LaskaKit/ESP32-S3-DEVKit/Version.md

### Version 1.3
- New power part, layout optimization | 
- Jumpers added to USB-HOST power
- New user button on pin io40
#### Version 1.2
- Adjustment of the IC1 switching | Upravá spinání IC1
#### Version 1.1
- D4 deleted | odstraněná dioda D4
#### Version 1.0
- Initial | Počáteční
