LaskaKit/ESP32-S3-DEVKit/img/ESP32-S3-DEVKit_back.png

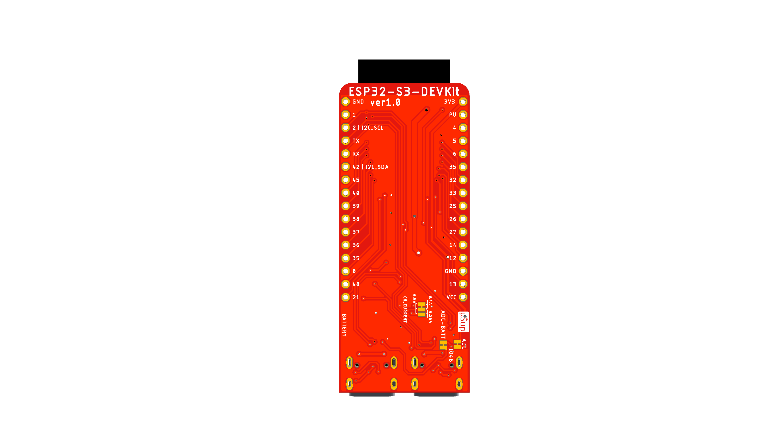
img/ESP32-S3-DEVKit_back.png
