LaskaKit/ESP32-S3-DEVKit/img/ESP32-S3-Devkit_pinout.JPG

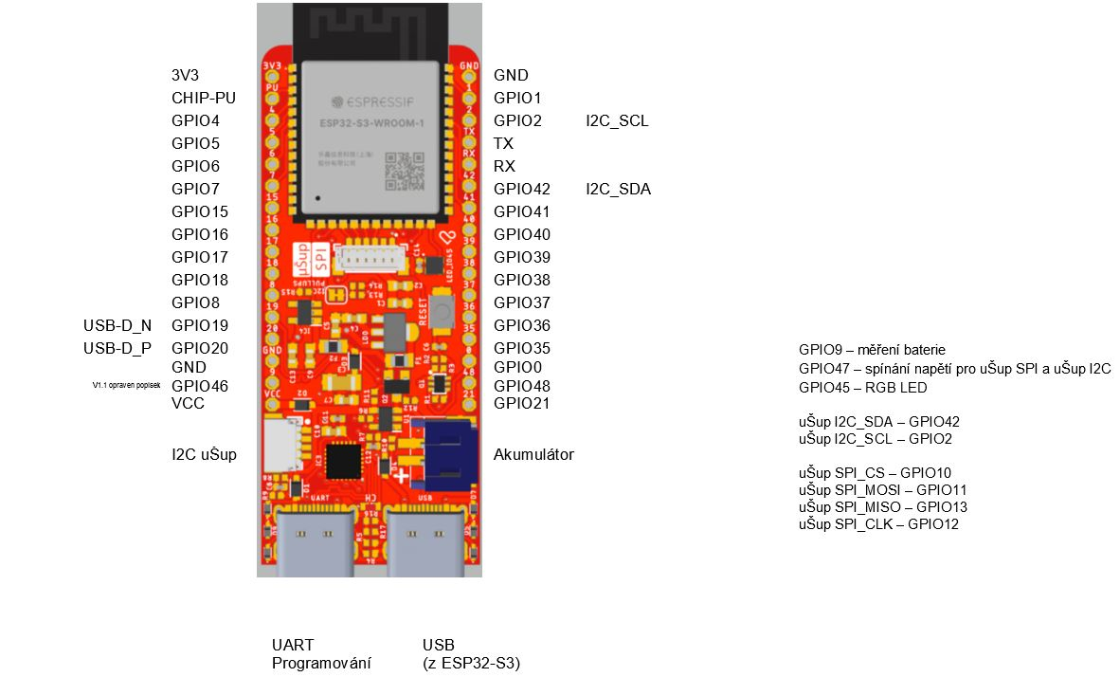
img/ESP32-S3-Devkit_pinout.JPG
