LaskaKit/ESP32-S3-DEVKit/img/LaskaKit-esp32-s3-devkit-1.jpg

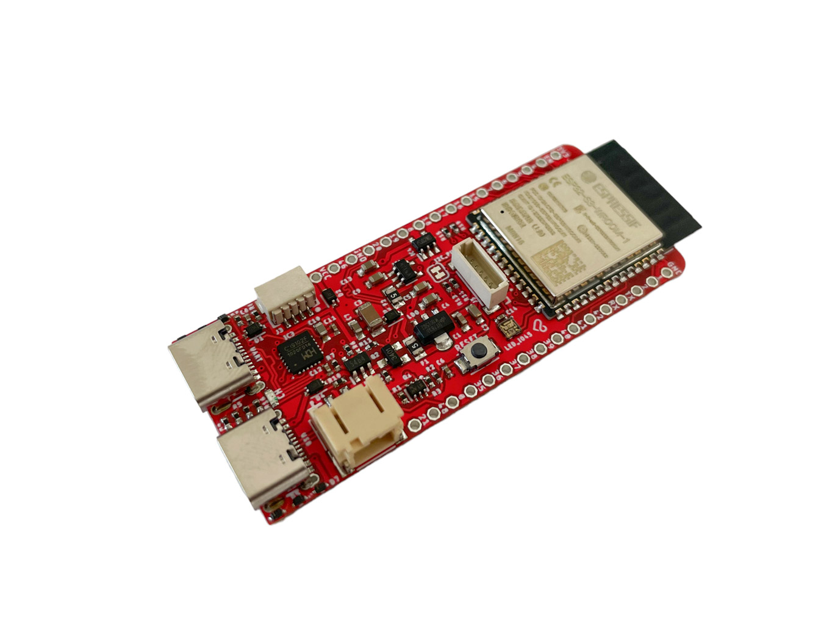
img/LaskaKit-esp32-s3-devkit-1.jpg
