LaskaKit/ESP32-S3-DEVKit/HW/ESP32-S3-DEVKit_v1_3.pdf

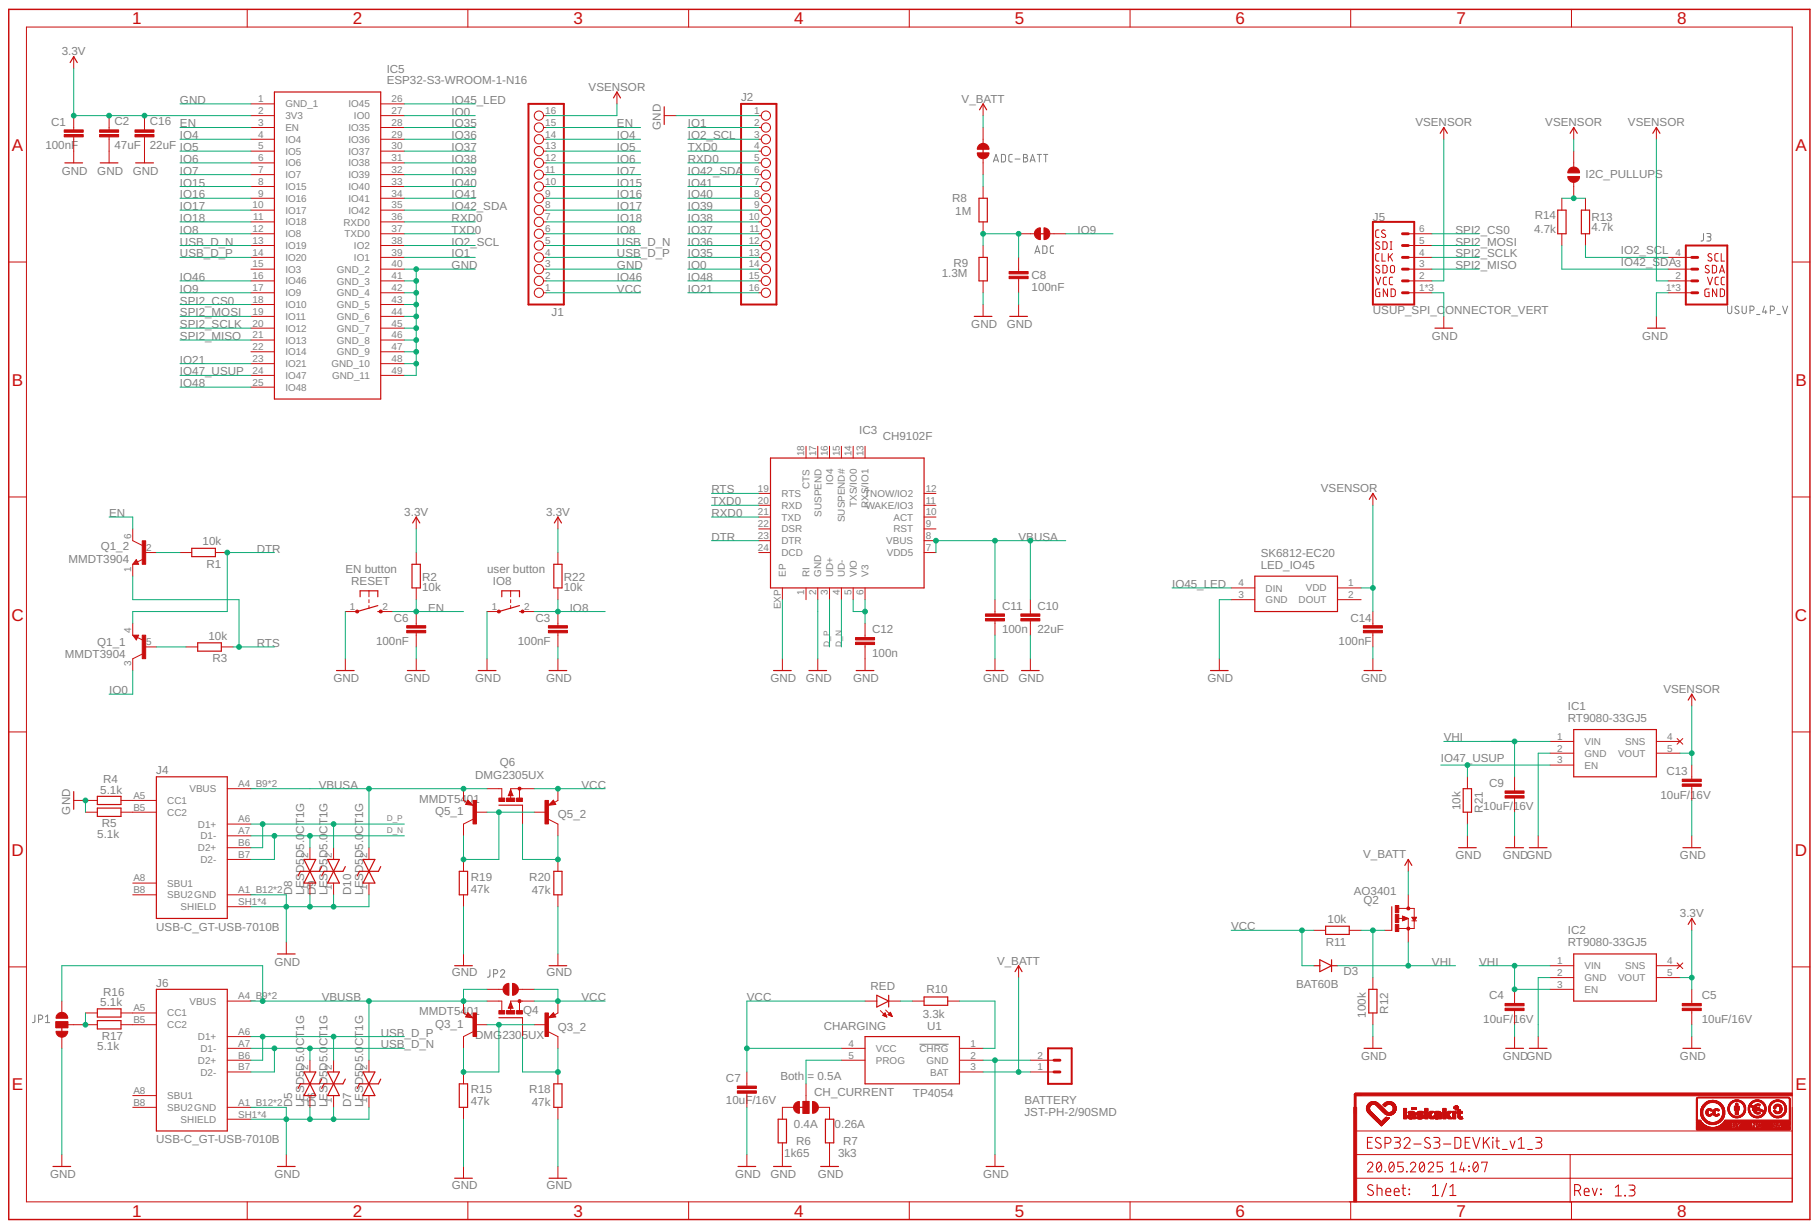
[picture p7: page 1]
