LaskaKit/ESP32-S3-DEVKit/HW/old/ESP32-S3-DEVKit_v1_1.pdf

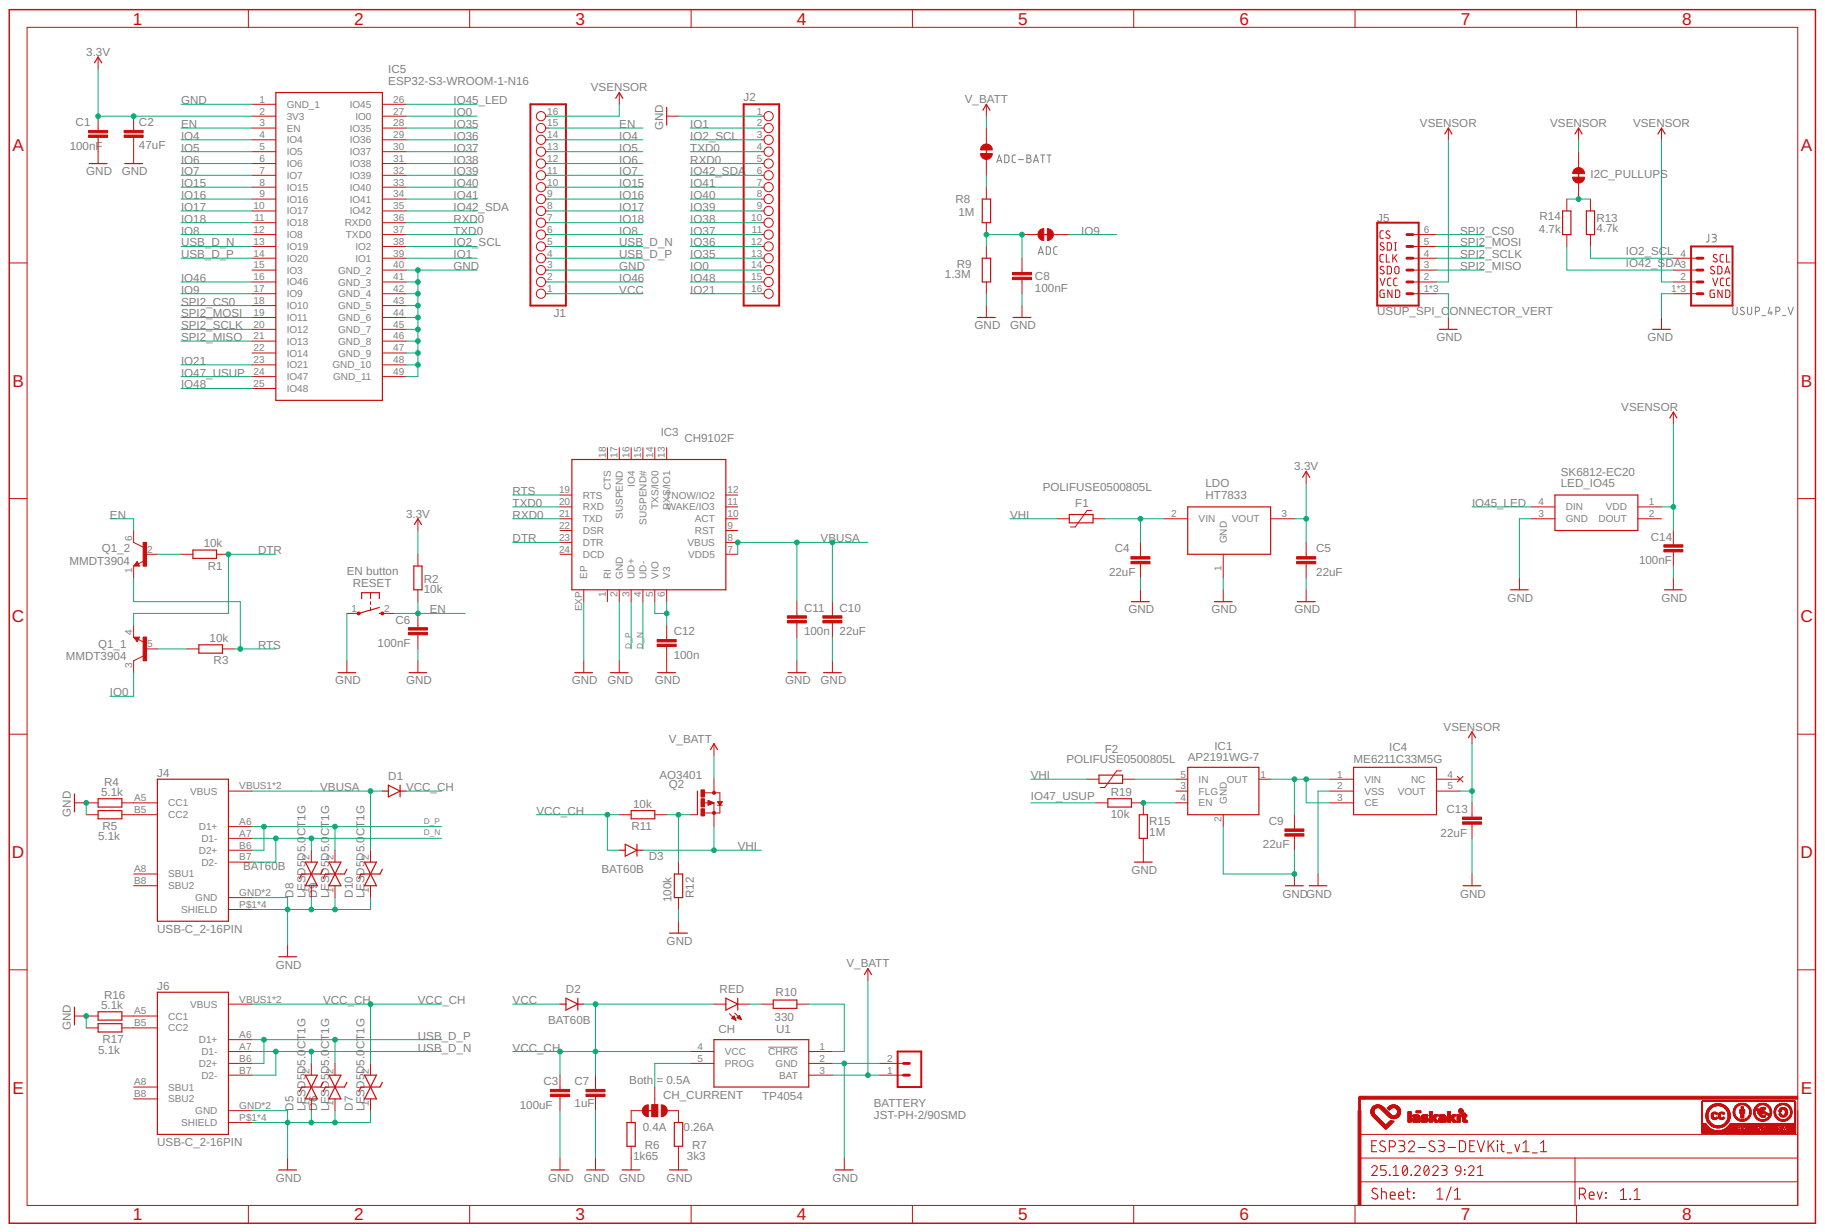
[picture p8: page 1]
