LaskaKit/ESP32-S3-DEVKit/HW/old/ESP32-S3-DEVKit_V1_0.pdf

A

1 | 2 | 3 | 4 | 5 | 6 | 7 | 8

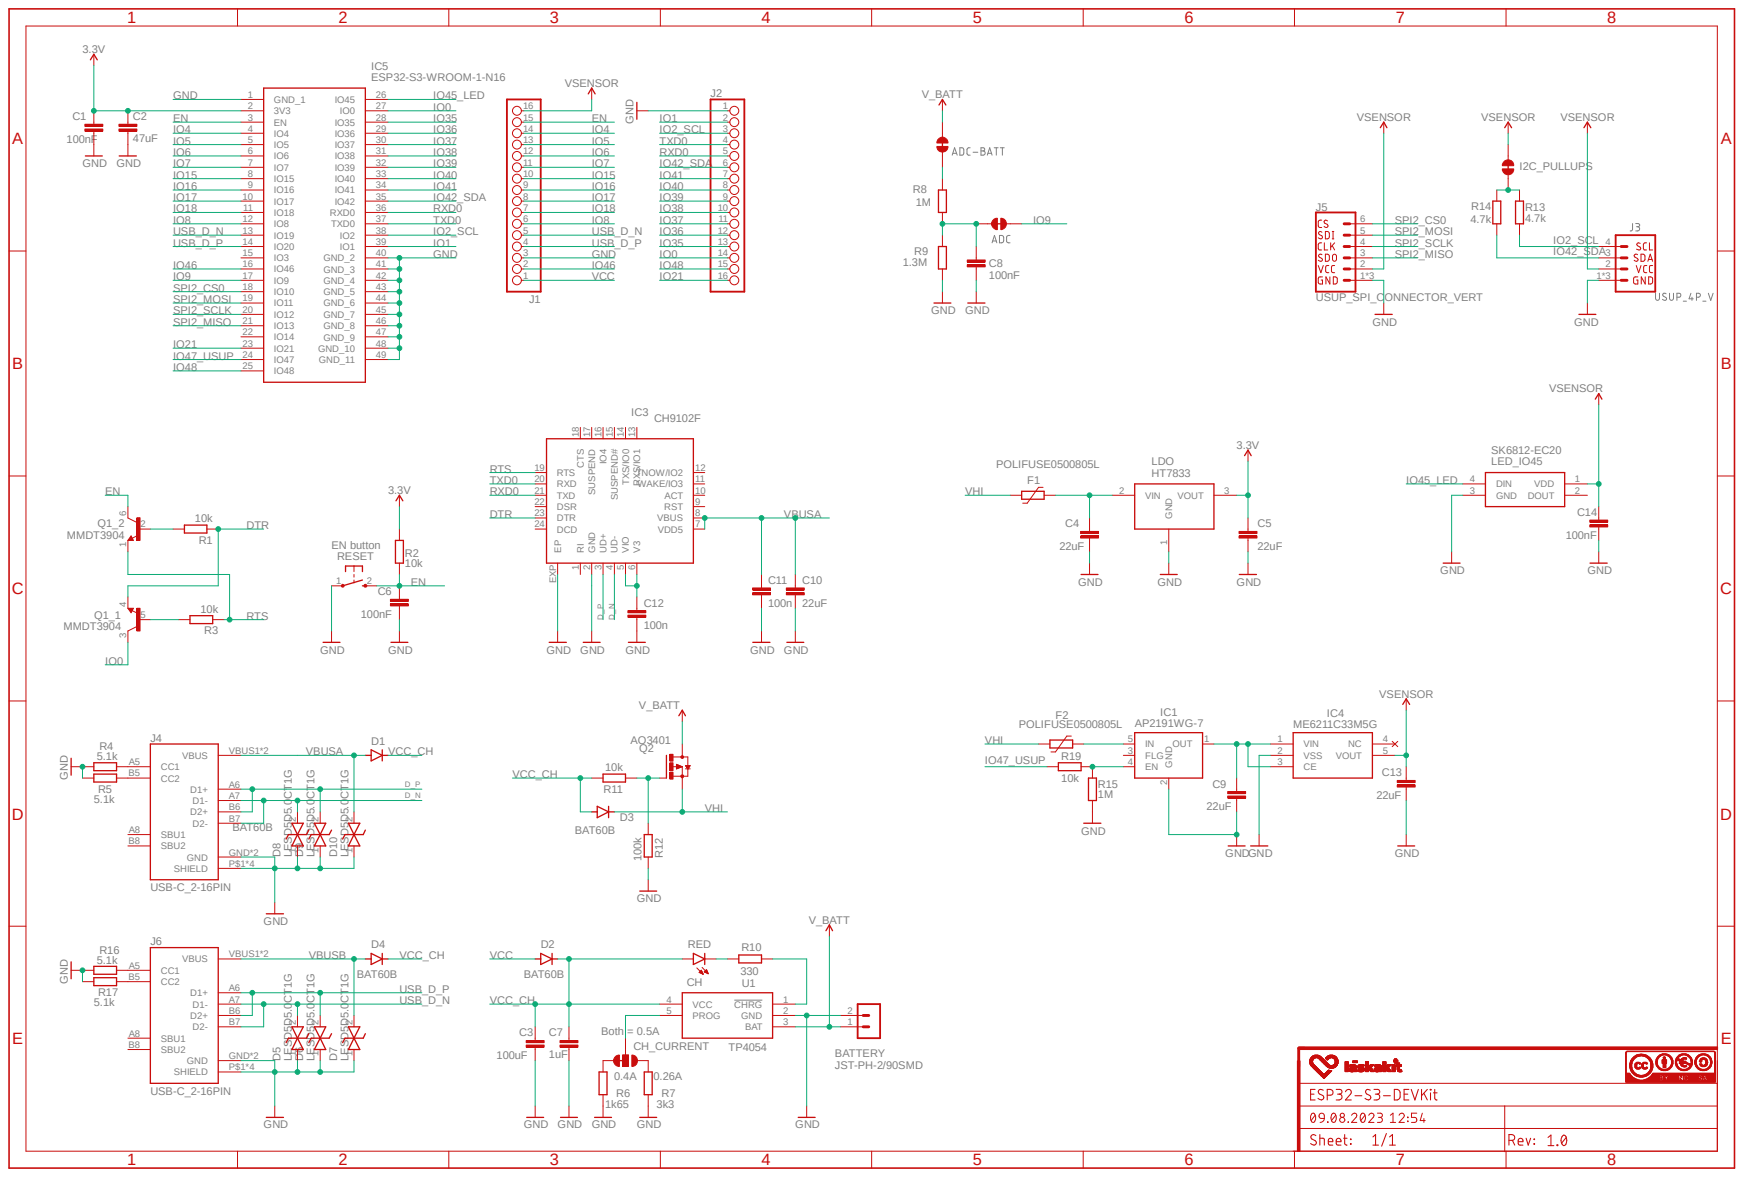
[picture p9: page 1]
