LaskaKit/ESP32-S3-DEVKit/SW/ESP32-S3_DEVKit_SHT4x/ESP32-S3_DEVKit_SHT4x.ino

/*
* This example code is used for LaskaKit ESP32-S3-DEVKit board https://www.laskakit.cz/laskakit-esp32-s3-devkit/
* with our Temperature and Humidity SHT40 module https://www.laskakit.cz/laskakit-sht40-senzor-teploty-a-vlhkosti-vzduchu/
* ESP32-S3-DEVKit board reads temperature and humidity from SHT40 sensor 
* and sends every second through UART
* 
*
* Made by (c) laskakit.cz 2023
*
* 
*/
#include "Adafruit_SHT4x.h"

#define PIN_ON 47


Adafruit_SHT4x sht4 = Adafruit_SHT4x();

void setup() {
  Serial.begin(115200);

  while (!Serial)
    delay(10);     // will pause Zero, Leonardo, etc until serial console opens

  pinMode(PIN_ON, OUTPUT);      // Set EN pin for second stabilisator as output
  digitalWrite(PIN_ON, HIGH);   // Turn on the second stabilisator

  Wire.begin(42, 2);            // set dedicated I2C pins 42 - SDA, 2 - SCL for ESP32-S3-DEVKit

  Serial.println("Adafruit SHT4x test");
  if (! sht4.begin()) {
    Serial.println("Couldn't find SHT4x");
    while (1) delay(1);
  }
  Serial.println("Found SHT4x sensor");
  Serial.print("Serial number 0x");
  Serial.println(sht4.readSerial(), HEX);

  // You can have 3 different precisions, higher precision takes longer
  sht4.setPrecision(SHT4X_HIGH_PRECISION);
  switch (sht4.getPrecision()) {
     case SHT4X_HIGH_PRECISION: 
       Serial.println("High precision");
       break;
     case SHT4X_MED_PRECISION: 
       Serial.println("Med precision");
       break;
     case SHT4X_LOW_PRECISION: 
       Serial.println("Low precision");
       break;
  }

  // You can have 6 different heater settings
  // higher heat and longer times uses more power
  // and reads will take longer too!
  sht4.setHeater(SHT4X_NO_HEATER);
  switch (sht4.getHeater()) {
     case SHT4X_NO_HEATER: 
       Serial.println("No heater");
       break;
     case SHT4X_HIGH_HEATER_1S: 
       Serial.println("High heat for 1 second");
       break;
     case SHT4X_HIGH_HEATER_100MS: 
       Serial.println("High heat for 0.1 second");
       break;
     case SHT4X_MED_HEATER_1S: 
       Serial.println("Medium heat for 1 second");
       break;
     case SHT4X_MED_HEATER_100MS: 
       Serial.println("Medium heat for 0.1 second");
       break;
     case SHT4X_LOW_HEATER_1S: 
       Serial.println("Low heat for 1 second");
       break;
     case SHT4X_LOW_HEATER_100MS: 
       Serial.println("Low heat for 0.1 second");
       break;
  }
  
}


void loop() {
  sensors_event_t humidity, temp;
  
  uint32_t timestamp = millis();
  sht4.getEvent(&humidity, &temp);// populate temp and humidity objects with fresh data
  timestamp = millis() - timestamp;

  Serial.print("Temperature: "); Serial.print(temp.temperature); Serial.println(" degrees C");
  Serial.print("Humidity: "); Serial.print(humidity.relative_humidity); Serial.println("% rH");

  Serial.print("Read duration (ms): ");
  Serial.println(timestamp);

  delay(1000);
}
