LaskaKit/ESP32-S3-DEVKit/SW/ESP32-S3_DEVKit_LED/ESP32-S3_DEVKit_LED.ino

/*
* This example code is used for LaskaKit ESP32-S3-DEVKit board  https://www.laskakit.cz/laskakit-esp32-s3-devkit/
* ESP32-S3-DEVKit just changing LED color 
* 
* Made by (c) laskakit.cz 2023
* 
*/

#include <Adafruit_NeoPixel.h>
#define PIN_ON 47
#define PIN_LED 45

Adafruit_NeoPixel pixels = Adafruit_NeoPixel(1, PIN_LED, NEO_GRB + NEO_KHZ800);

void setup() {
  Serial.begin(115200);
  pinMode(PIN_ON, OUTPUT);      // Set EN pin for second stabilisator as output
  digitalWrite(PIN_ON, HIGH);   // Turn on the second stabilisator

  pixels.begin();
  pixels.setBrightness(10);
}

void loop() {
     
  pixels.setPixelColor(0, pixels.Color(255, 0, 0)); // R, G, B
  pixels.show();

  delay(1000);

  pixels.setPixelColor(0, pixels.Color(0, 255, 0)); // R, G, B
  pixels.show();

  delay(1000);

  pixels.setPixelColor(0, pixels.Color(0, 0, 255)); // R, G, B
  pixels.show();

  delay(1000);

  pixels.setPixelColor(0, pixels.Color(255, 255, 255)); // R, G, B
  pixels.show();

  delay(1000);

}
