LaskaKit/ESP32-S3-DEVKit/(commit log)

2025-06-04 new ver
    [ESP32-S3-DEVKit_v1_2_top_bom.csv, ESP32-S3-DEVKit_v1_3_bom.csv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]
2026-03-10 new prototype
    [ESP32-S3-DEVKit v5_bom.csv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]
